Circuitnoise/Phonosynth/Docs/ps_dronesynth.png

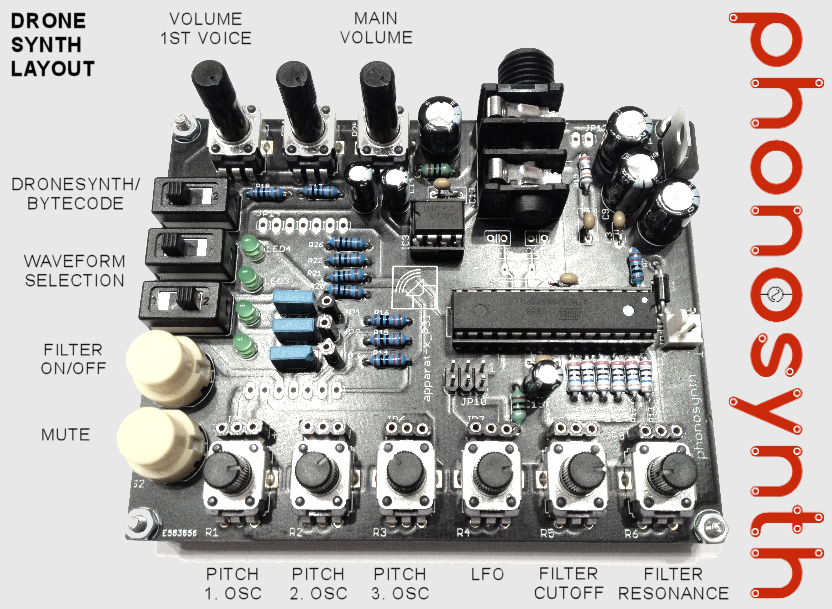
Docs/ps_dronesynth.png
