Circuitnoise/Phonosynth/README.md

Phonosynth
==========

Der Phonosynth P31, eine erweiterbare Open-Source Synthesizer Plattform!

Hardware:

    Atmel ATmega Microcontroller
    1 Lautstärkeregler
    2 Mixer-Regler für den 2. bzw. 3. Oszillator
    bis zu 3 Schalter
    bis zu 2 Taster
    bis zu 6 Poti Parameterregler
    Batterie-/ Netzteilanschluß
    Lautsprecherverstärker
    Lautsprecheranschluß
    Ausgang: große Klinke
    SPI Programmierschnittstelle
    gesockelter Chip zum schnellen Austausch
    Zusätzliche Stiftausgänge zur manuellen Modulation der Pulswellen
    Breakout Pins um ein zusätzliches Board oder Bauteile anzuschließen

Programmierbar, vorprogrammiert mit 2 Soundengines:

    ByteBeat-Player - mehr Informationen hier
    Drone-Synthesizer mit bis zu 3 Stimmen und Filter

    weitere Software Defined Sound Engine(s) möglich
    Open Source, eigene Erweiterungen oder Änderungen möglich
